ssysy/AC-to-DC-Power-Converter/README.md

# AC-to-DC-Power-Converter
AC to DC Power Converter design and implementation

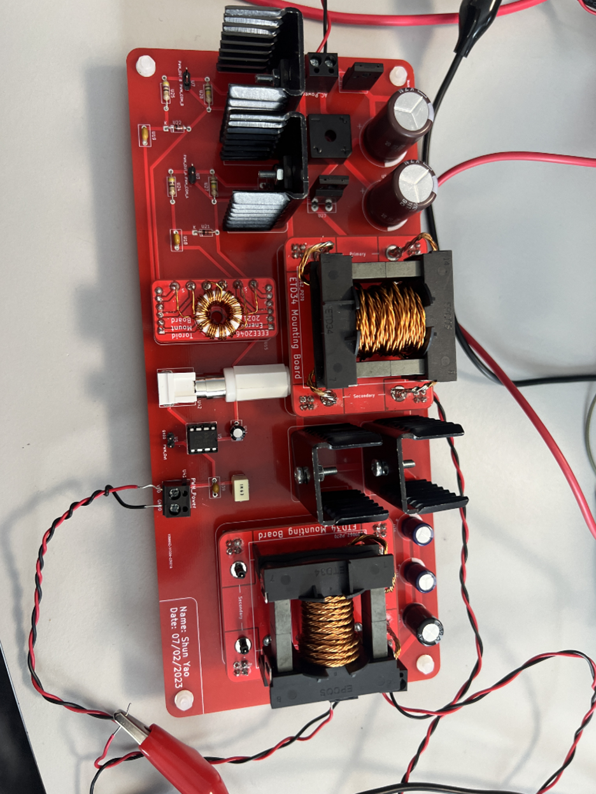
[picture p1: Board_PCB.png]


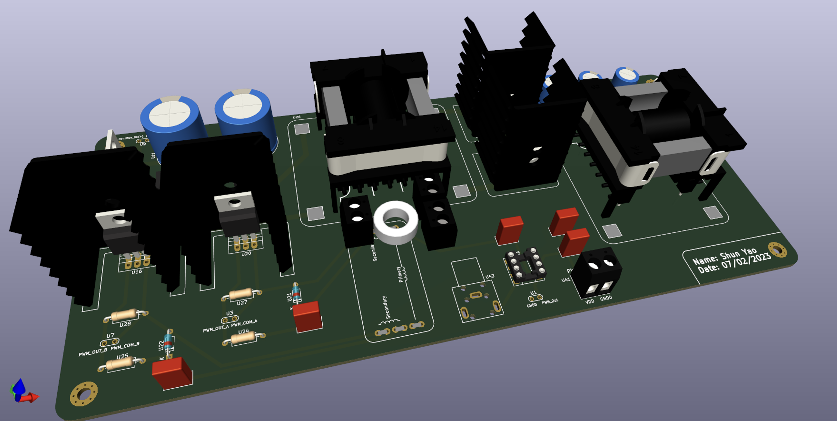
[picture p2: 3D_PCB.png]


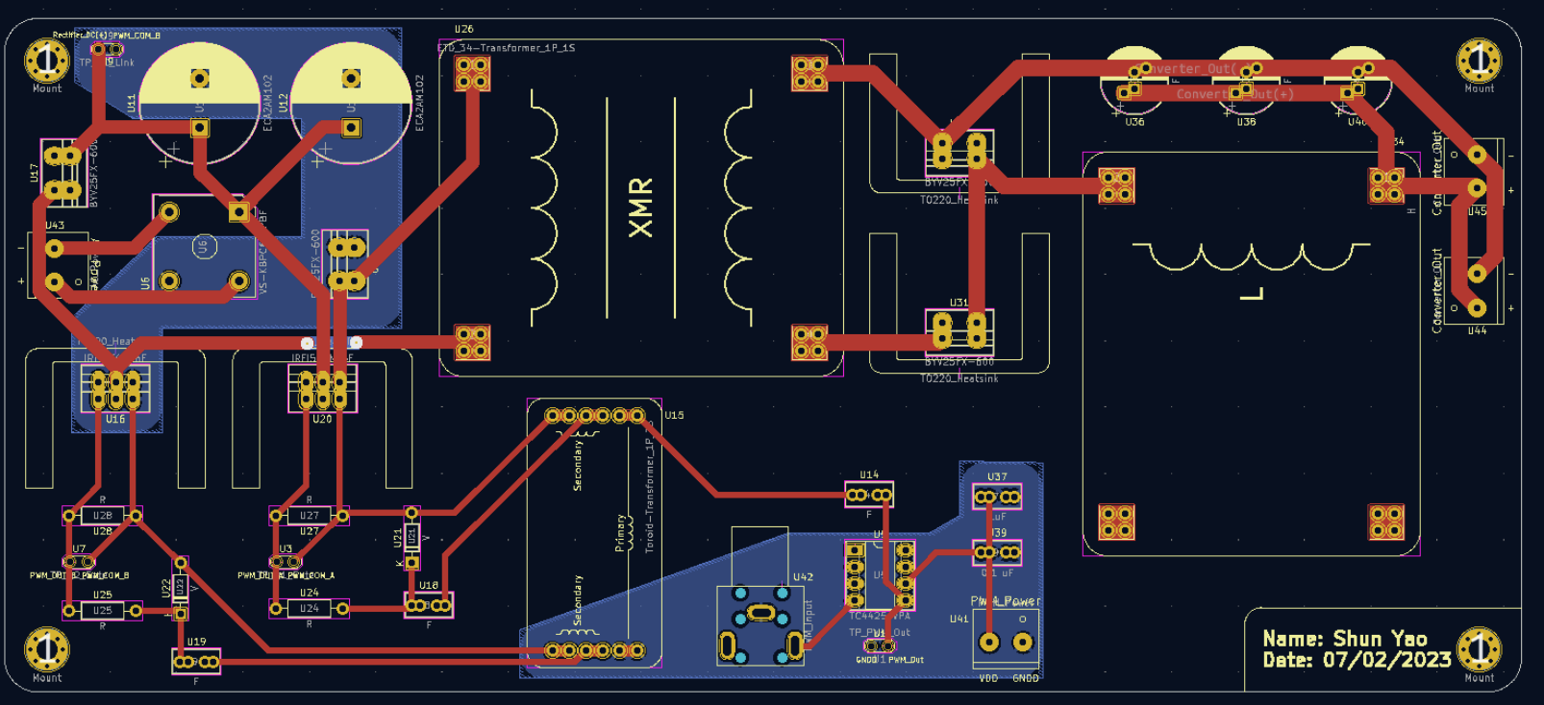
[picture p3: Layout_PCB.png]


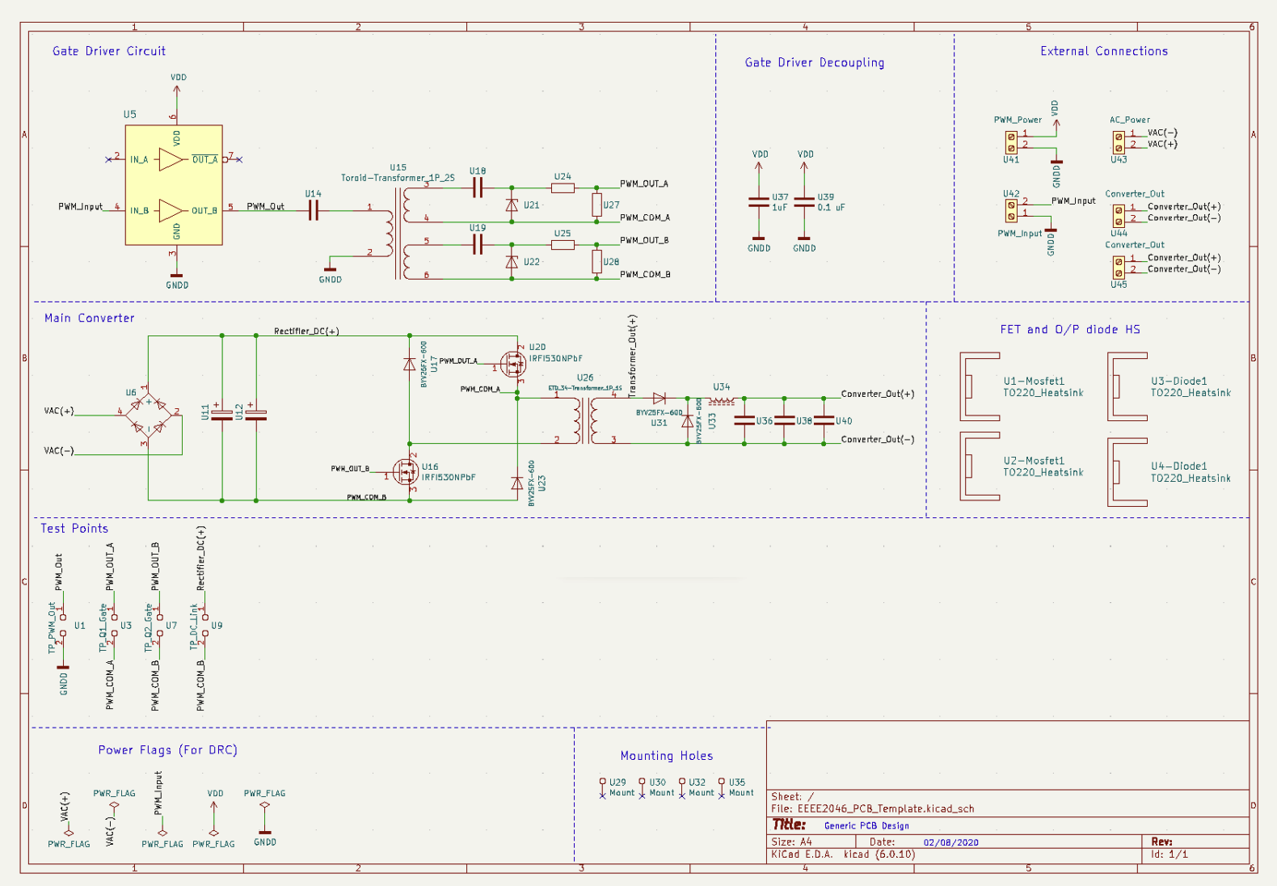
[picture p4: Schematic_PCB.png]
