ssysy/AC-to-DC-Power-Converter/PCB Board Schematic and Layout.docx

PCB Board Schematic:

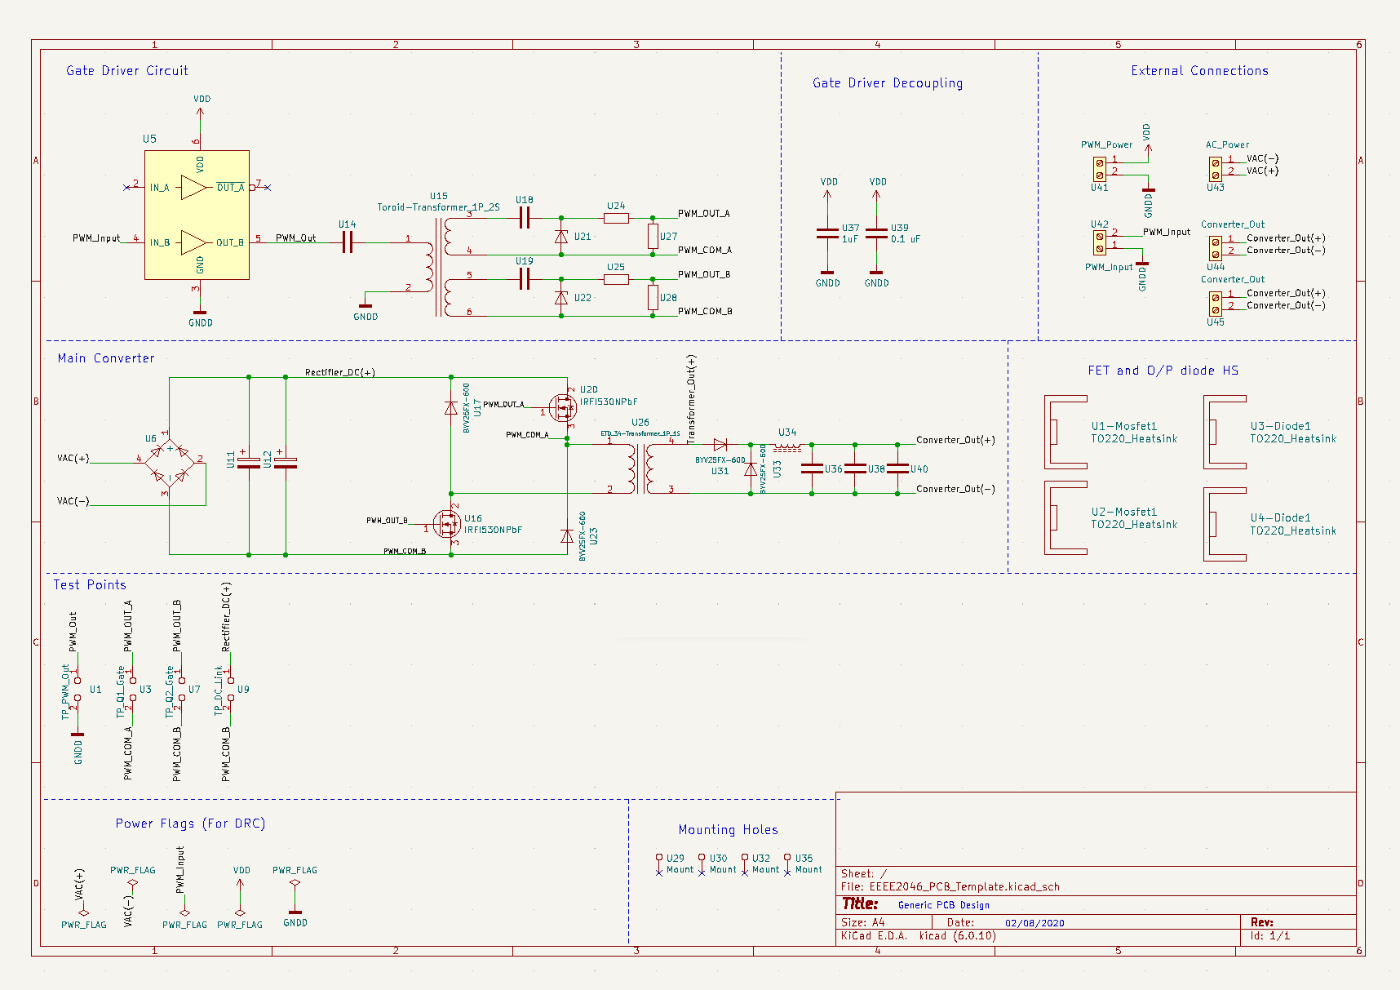
[picture p5: figure]

PCB Layout Design:

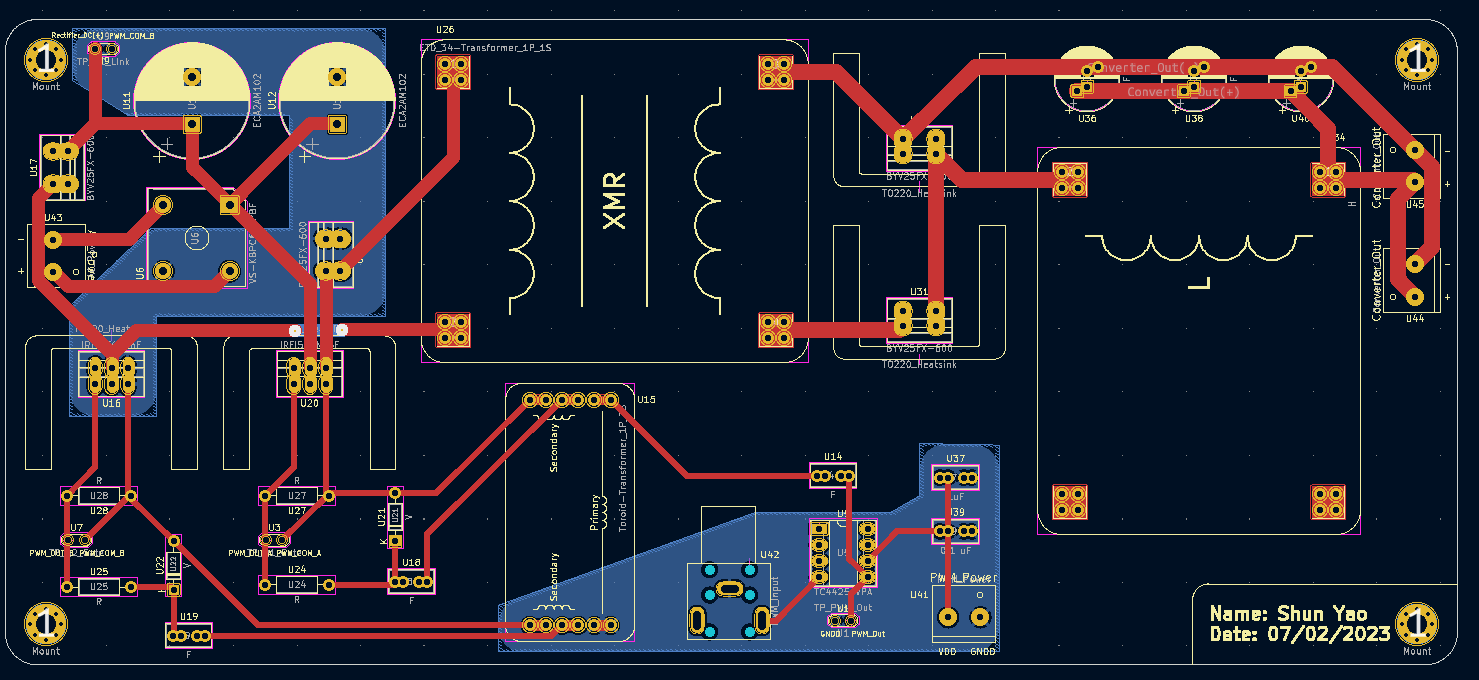
[picture p6: figure]
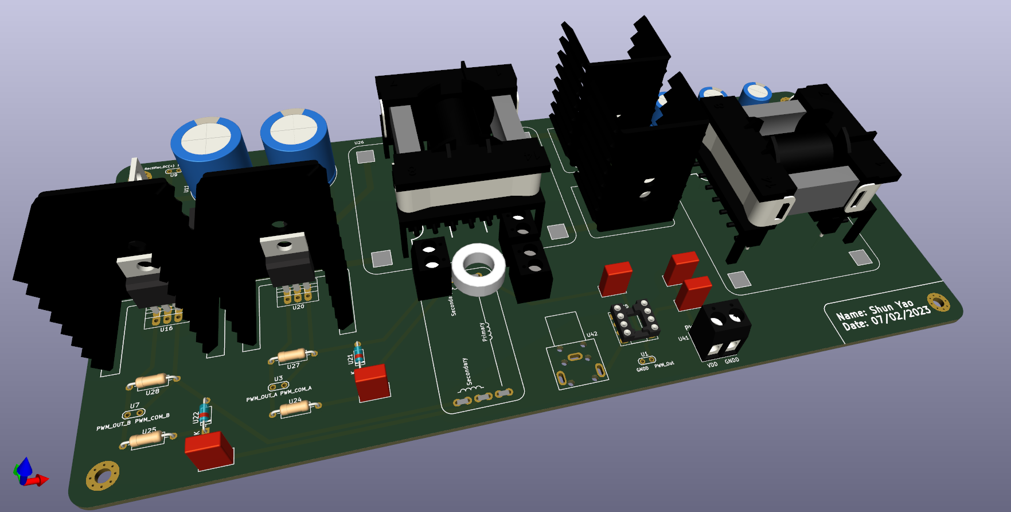
[picture p7: figure]

Manufactured PCB Board:

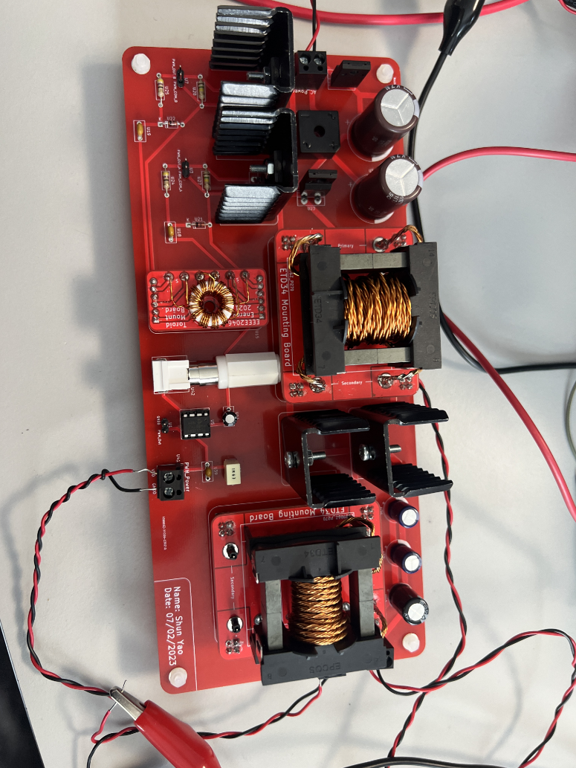
[picture p8: figure]
